holla2040/NMNSH_F-16_Lighting_Controller/README.md

NMNSH_F-16_Lighting_Controller
==============================

NMNSH F-16 Lighting Controller, based on Lucky7



<iframe width="840" height="630" src="//www.youtube.com/embed/kfMw8MljeAU" frameborder="0" allowfullscreen></iframe><br>

Here's the <a href='http://www.spudcentral.com/potd/141114.html'>project summary</a> page. Check it out!
