holla2040/NMNSH_F-16_Lighting_Controller/src/f-16_ext_lighting_panel.gif

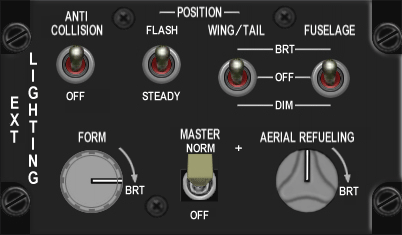
src/f-16_ext_lighting_panel.gif
