holla2040/NMNSH_F-16_Lighting_Controller/board/NMNSH F-16 Lighting Controller.pdf

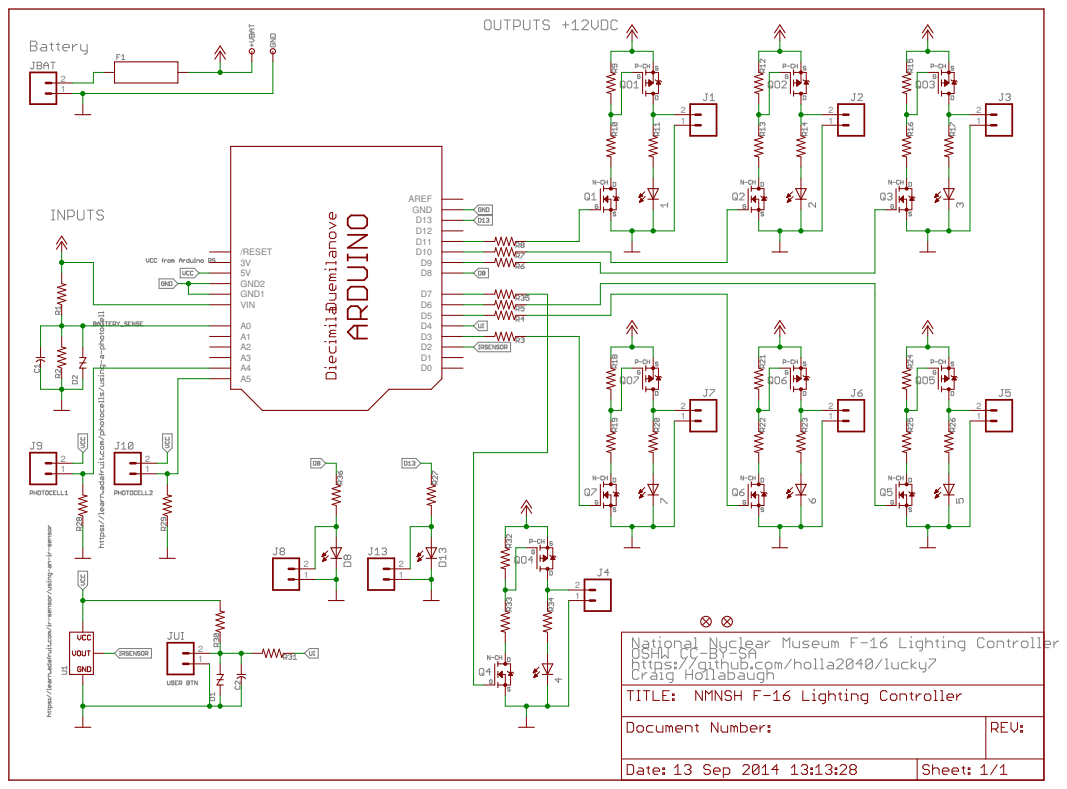
[picture p3: page 1]
