holla2040/NMNSH_F-16_Lighting_Controller/board/NMNSH F-16 Lighting Controller.brd.pdf

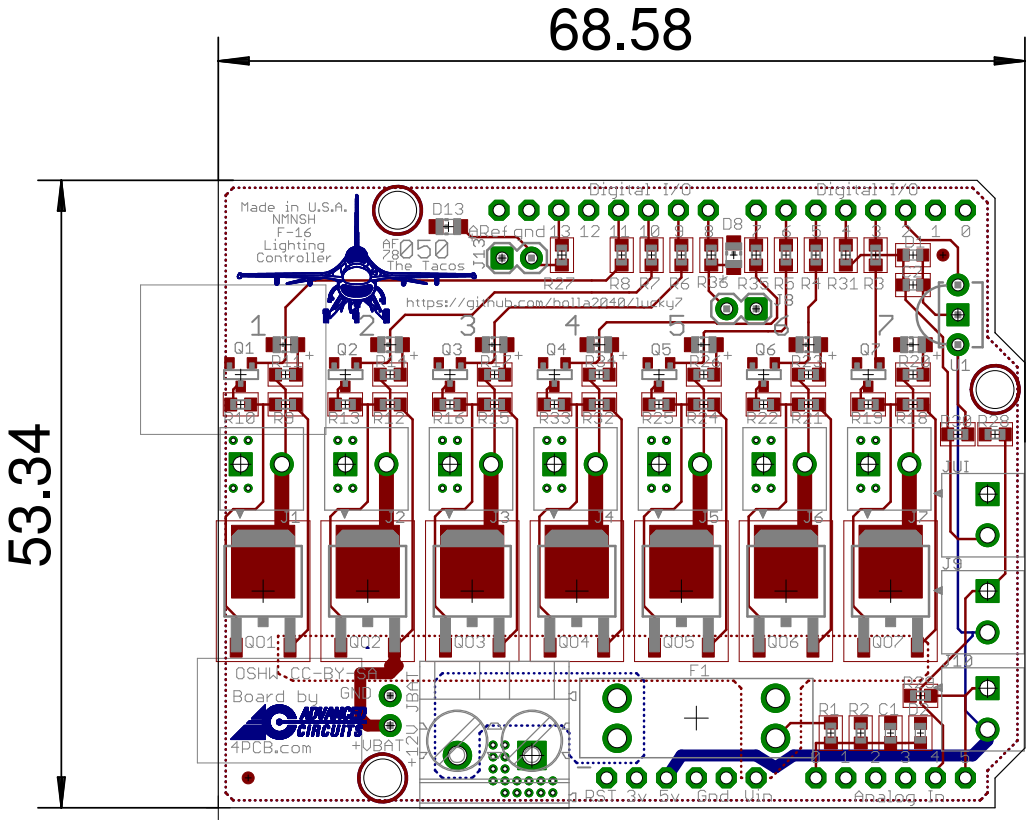
[picture p4: page 1]
