holla2040/NMNSH_F-16_Lighting_Controller/board/NMNSH F-16 Lighting Controller.sch.pdf

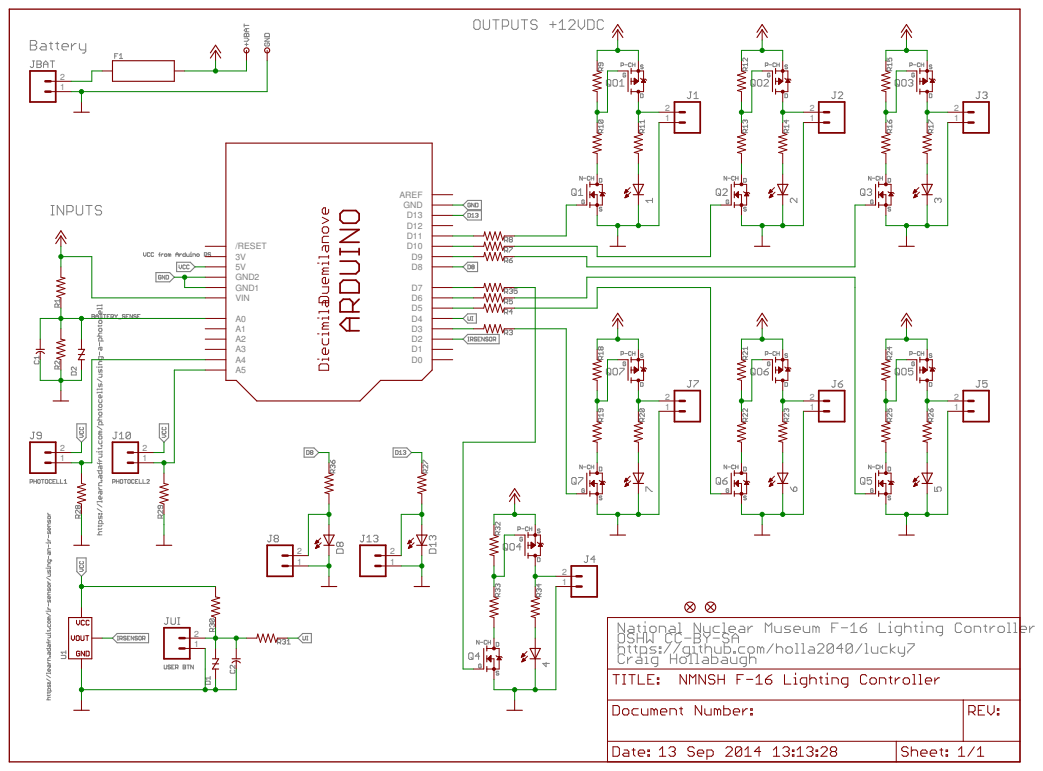
[picture p5: page 1]
