holla2040/NMNSH_F-16_Lighting_Controller/board/NMNSH F-16 Lighting Controller.brd

## EAGLE design board/NMNSH F-16 Lighting Controller.brd (2014-09-13)

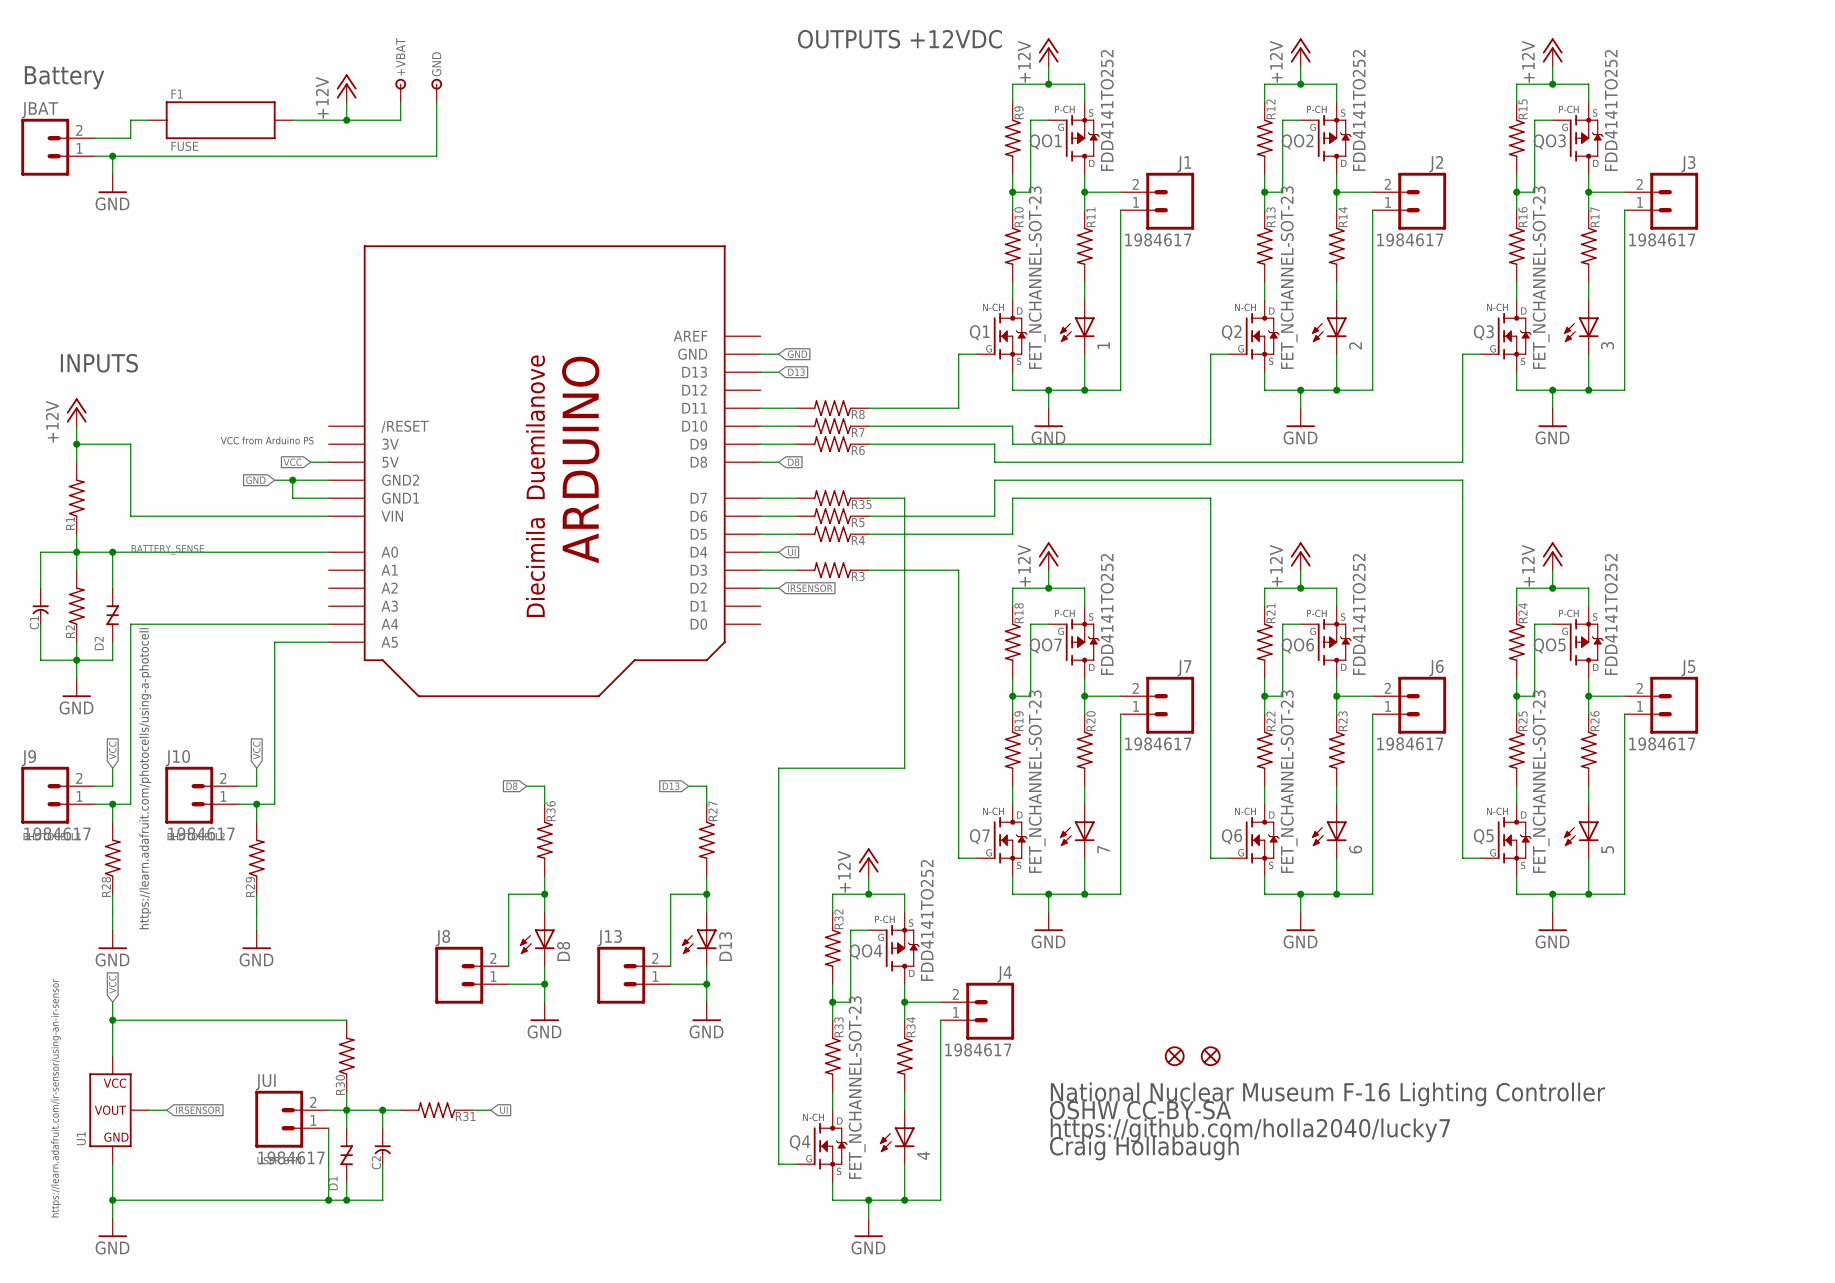
[picture p6: schematic NMNSH F-16 Lighting Controller.sch]

Parts:
1, 2, 3, 4, 5, 6, 7: LEDCHIP-LED0805; CHIP-LED0805
+VBAT: TESTPOINTTHRU; TPTHRU
C1, C2: C-USC0603; C0603
D1, D2: TVS0603; TVS-0603
D8, D13: LEDCHIP-LED0805; CHIP-LED0805
F1: FUSE; FUSE-3557-2
GND: TESTPOINTTHRU; TPTHRU
J1, J2, J3, J4, J5, J6, J7, J9, J10: 1984617
J8, J13: M02-0.1; 1X02
JBAT: M02-6.35MM; OSTT702
JP1, JP2: FIDUCIAL1X2; FIDUCIAL-1X2
JUI: 1984617
Q1, Q2, Q3, Q4, Q5, Q6, Q7: FET_NCHANNEL-SOT-23; SOT-23
QO1, QO2, QO3, QO4, QO5, QO6, QO7: FDD4141TO252; TO252
R1, R2, R3, R4, R5, R6, R7, R8, R9, R10, R11, R12, R13, R14, R15, R16, R17, R18, R19, R20, R21, R22, R23, R24, R25, R26, R27, R28, R29, R30, R31, R32, R33, R34, R35, R36: R-US_R0603; R0603
U1: IRDETECTOR-THRU
U100: ARDUINO-BPLACE

Connections:
3V: U100.3V
+12V: +VBAT.1, F1.2@1, F1.2@2, QO1.2 (S), QO2.2 (S), QO3.2 (S), QO4.2 (S), QO5.2 (S), QO6.2 (S), QO7.2 (S), R1.2, R9.1, R12.1, R15.1, R18.1, R21.1, R24.1, R32.1, U100.VIN
BATTERY_SENSE: C1.1, D2.1, R1.1, R2.2, U100.A0
D8: R36.1, U100.D8
D13: R27.1, U100.D13
GND: 1.C, 2.C, 3.C, 4.C, 5.C, 6.C, 7.C, C1.2, C2.2, D1.2, D2.2, D8.C, D13.C, GND.1, J1.1, J2.1, J3.1, J4.1, J5.1, J6.1, J7.1, J8.1, J13.1, JBAT.1, JUI.1, Q1.3 (S), Q2.3 (S), Q3.3 (S), Q4.3 (S), Q5.3 (S), Q6.3 (S), Q7.3 (S), R2.1, R28.1, R29.1, U1.GND, U100.GND, U100.GND1, U100.GND2
IRSENSOR: U1.VOUT, U100.D2
unnamed: QO1.1 (G), R9.2, R10.1
unnamed: Q1.1 (D), R10.2
unnamed: R8.2, U100.D11
unnamed: J9.1, R28.2, U100.A4
unnamed: 1.A, R11.2
unnamed: R7.2, U100.D10
unnamed: R6.2, U100.D9
unnamed: R5.2, U100.D6
unnamed: R4.2, U100.D5
unnamed: R3.2, U100.D3
unnamed: QO2.1 (G), R12.2, R13.1
unnamed: Q2.1 (D), R13.2
unnamed: 2.A, R14.2
unnamed: QO3.1 (G), R15.2, R16.1
unnamed: Q3.1 (D), R16.2
unnamed: 3.A, R17.2
unnamed: QO7.1 (G), R18.2, R19.1
unnamed: Q7.1 (D), R19.2
unnamed: 7.A, R20.2
unnamed: QO6.1 (G), R21.2, R22.1
unnamed: Q6.1 (D), R22.2
unnamed: 6.A, R23.2
unnamed: QO5.1 (G), R24.2, R25.1
unnamed: Q5.1 (D), R25.2
unnamed: 5.A, R26.2
unnamed: Q1.2 (G), R8.1
unnamed: Q2.2 (G), R7.1
unnamed: Q3.2 (G), R6.1
unnamed: Q5.2 (G), R5.1
unnamed: Q6.2 (G), R4.1
unnamed: Q7.2 (G), R3.1
unnamed: J10.1, R29.2, U100.A5
unnamed: C2.1, D1.1, JUI.2, R30.1, R31.2
unnamed: D13.A, J13.2, R27.2
unnamed: QO4.1 (G), R32.2, R33.1
unnamed: Q4.1 (D), R33.2
unnamed: D8.A, J8.2, R36.2
unnamed: 4.A, R34.2
unnamed: Q4.2 (G), R35.1
unnamed: R35.2, U100.D7
O1: J1.2, QO1.3 (D), R11.1
O2: J2.2, QO2.3 (D), R14.1
O3: J3.2, QO3.3 (D), R17.1
O4: J4.2, QO4.3 (D), R34.1
O5: J5.2, QO5.3 (D), R26.1
O6: J6.2, QO6.3 (D), R23.1
O7: J7.2, QO7.3 (D), R20.1
UI: R31.1, U100.D4
VBAT: F1.1@1, F1.1@2, JBAT.2
VCC: J9.2, J10.2, R30.2, U1.VCC, U100.5V

Notes on the sheet:
PHOTOCELL1
PHOTOCELL2
https://learn.adafruit.com/photocells/using-a-photocell
USER BTN
VCC from Arduino PS
https://learn.adafruit.com/ir-sensor/using-an-ir-sensor
INPUTS
OUTPUTS +12VDC
Battery
https://github.com/holla2040/lucky7
OSHW CC-BY-SA
Craig Hollabaugh
National Nuclear Museum F-16 Lighting Controller

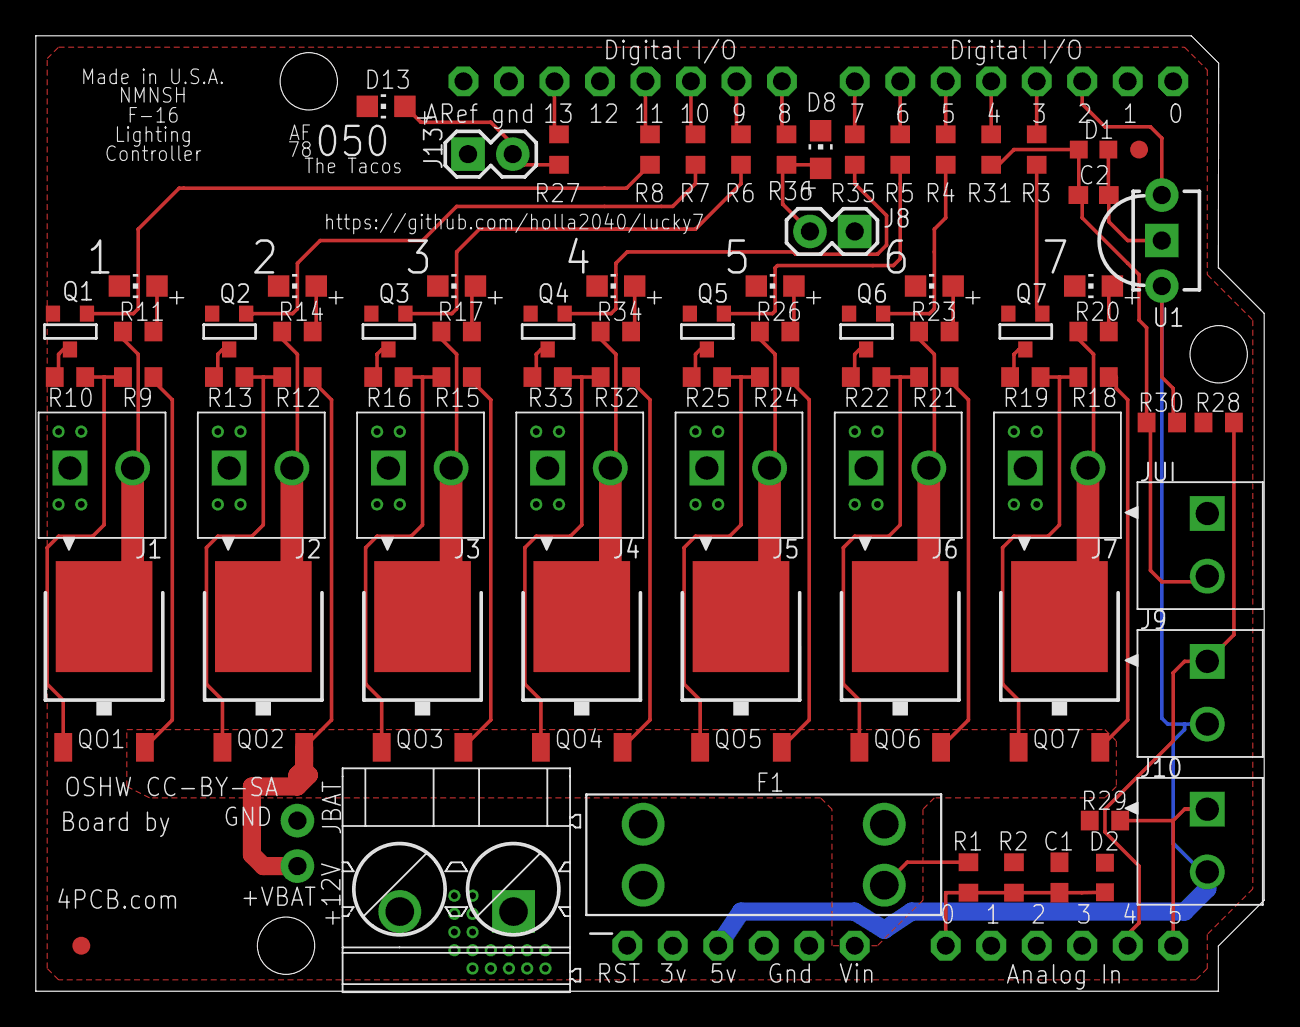
[picture p7: board NMNSH F-16 Lighting Controller.brd from above]

Board: 2 copper layers, 68.6 x 53.3 mm, 83 parts (0 on the bottom side), 56 nets.
