holla2040/NMNSH_F-16_Lighting_Controller/(commit log)

2014-09-13 initial add
    [NMNSH F-16 Lighting Controller.brd, NMNSH F-16 Lighting Controller.sch]
2014-09-14 Added makefile support from https://github.com/sudar/Arduino-Makefile, exporting these
    export ARDUINO_DIR=~/arduino
    export ARDMK_DIR=~/reference/a/arduino/makefile
    export AVR_TOOLS_DIR=~/arduino/hardware/tools/avr
    export AVRDUDE=$AVR_TOOLS_DIR/../avrdude
    export AVRDUDE_CONF=$AVR_TOOLS_DIR/../avrdude.conf
    export MONITOR_PORT=/dev/ttyUSB0
    ~/reference/a/arduino/makefile has Arduino.mk and Common.mk
2014-11-02 initial add for most first working version
    [F16 Light Dimming Plot.ods]
2014-11-02 corrected TIMEOUTEVENING to be milliseconds in 4 hours
    [F16.ino]
2014-11-02 added support for all light control added battery voltage detect and BATTERYLOW mode
2014-11-04 anti-collision - added a little state for 2 quick blink wing/inlet exp ramp down now includes a 300ms off time tweaked for negative pwm values, but masked off by time, increased to 1250ms cycles
    [F16 Light Dimming Plot.ods]
2014-11-04 tweaked ramp down params override mode status led blinks fast now
    [F16 Light Dimming Plot.ods]
2014-12-29 added watchdog reset after 30 days to keep millis() from rolling over
    [F16.ino]
